CheeseRyba/Projekt_TM/image/Srodek.jpg

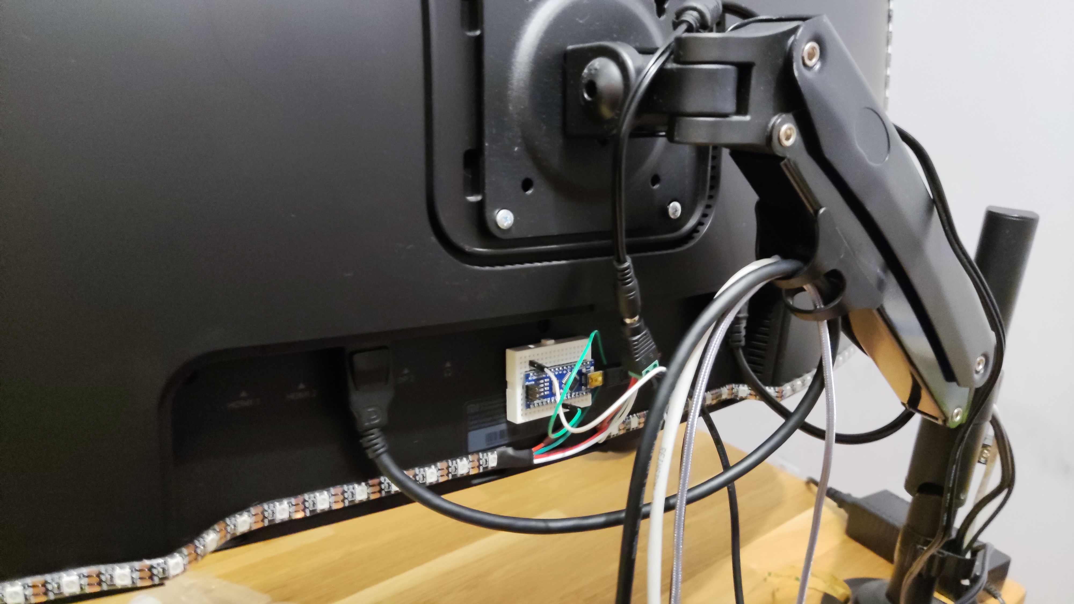
image/Srodek.jpg
