CheeseRyba/Projekt_TM/Hardware/SchematArduinoNanoEagle.sch

## EAGLE design Hardware/SchematArduinoNanoEagle.sch (2022-01-17)

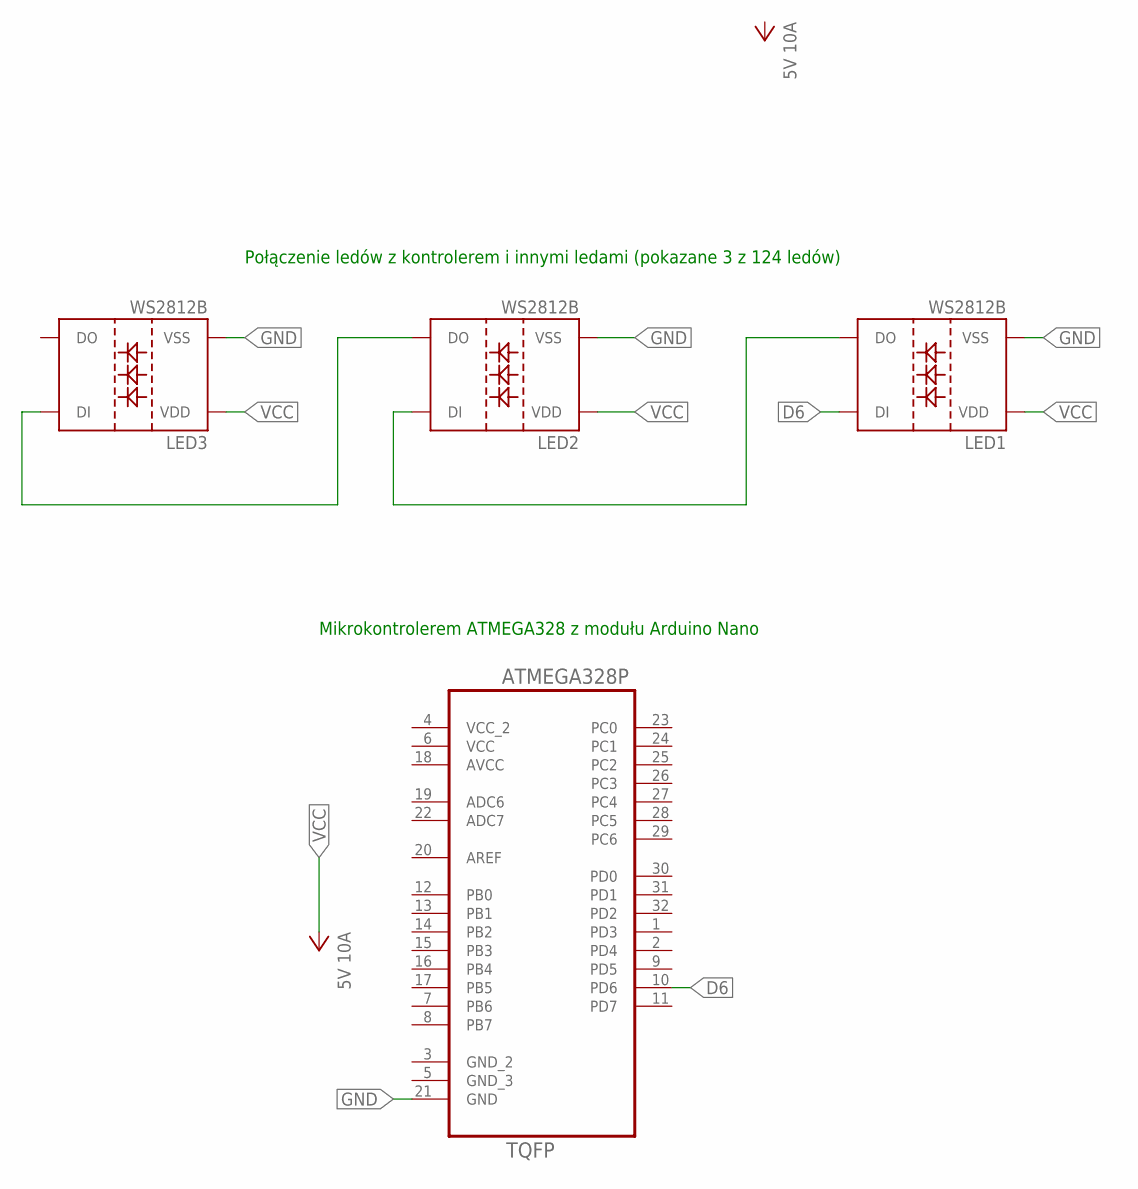
[picture p19: schematic SchematArduinoNanoEagle.sch]

Parts:
LED1, LED2, LED3: WS2812B
U1: ATMEGA328P-AU; QFP80P900X900X120-32N

Connections:
D6: LED1.4 (DI), U1.10 (PD6)
GND: LED1.3 (VSS), LED2.3 (VSS), LED3.3 (VSS), U1.21 (GND)
unnamed: LED1.2 (DO), LED2.4 (DI)
unnamed: LED2.2 (DO), LED3.4 (DI)
VCC: LED1.1 (VDD), LED2.1 (VDD), LED3.1 (VDD)

Notes on the sheet:
Mikrokontrolerem ATMEGA328 z modułu Arduino Nano
Połączenie ledów z kontrolerem i innymi ledami (pokazane 3 z 124 ledów)
